SandorBalazsHU/elte-submarine/README.md

# elte-submarine
elte submarine project.
