SandorBalazsHU/elte-submarine/documentation/BLOKK.pptx

Tengeralattjáró

Szerializált szöveg

RS485 üzenet

Joystic
vezérlő

Távirányító

Csatorna

Üzenet vevő

Motor Bal

Motor Jobb

RS485 üzenet

Nyers adat

Bemenet feldolgozó

FOLYTONOS

Szerializált szöveg

Üzenet

Üzenet kezelő

Üzenet kezelő

Üzenet

PWM
értékek

Motor Bal

PWM jel

Motor Jobb

Motor parancs
generátor

Üzenet küldő

Csatorna

Motor Bal

Motor Jobb

Motor vezérlő

PWM jel
