SandorBalazsHU/elte-submarine/documentation/joystick_graph.pptx

X:000 Y:675
X:MIN Y:MAX

X:331 Y:675
X:MID Y:MAX

X:675 Y:675
X:MAX Y:MAX

Y

X:000 Y:346
X:MIN Y:MID

X

X:675 Y:346
X:MAX Y:MID

X:000 Y:000
X:MIN Y:MIN

X:675 Y:000
X:MAX Y:MIN

X:331 Y:000
X:MID Y:MIN

LEF

RIG

PWM_MAX_FOR

PWM_FOR

DIFF_LEF

0

PWM_BAC

DIF_RIG

DIF_MAX

DIF_MAX

PWM_MAX_BAC

CEN

A

D

B

C

F

E
