SandorBalazsHU/elte-submarine/documentation/joystick_graph.png

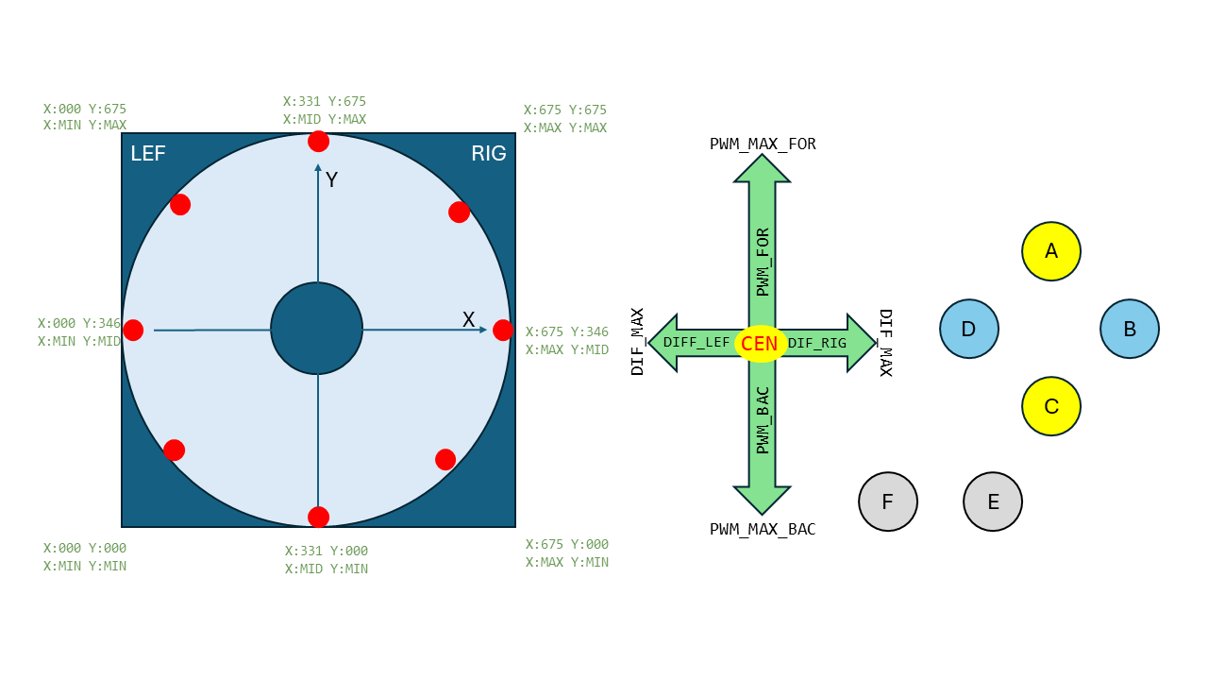
documentation/joystick_graph.png
