SandorBalazsHU/elte-submarine/(list of files, drawings)

Other design files:
documentation/Alkatreszek/PANGTEIH PROJECT.fzz
documentation/Alkatreszek/Test_water_sensor.fzz
documentation/PipeSub_Kapcsolasi_Rajz_01.fzz
documentation/PipeSub_Kapcsolasi_Rajz_02.fzz
