SandorBalazsHU/elte-submarine/(commit log)

2025-05-15 Working motor and joy
2025-05-15 Adding calibrators, calibrations, documentation and fixing shield class
    [elte-submarine.ino, joystick_calibrator.ino, motor_calibrator.ino]
2025-09-04 Ship 2 update
    [PANGTEIH PROJECT.fzz, PipeSub_Kapcsolasi_Rajz_01.fzz, PipeSub_Kapcsolasi_Rajz_02.fzz, Test_water_sensor.fzz]
